micgresham/lr2-redux/9bdd61c0-d4aa-4cd3-b29d-1bbbb40d1ae0.jpg

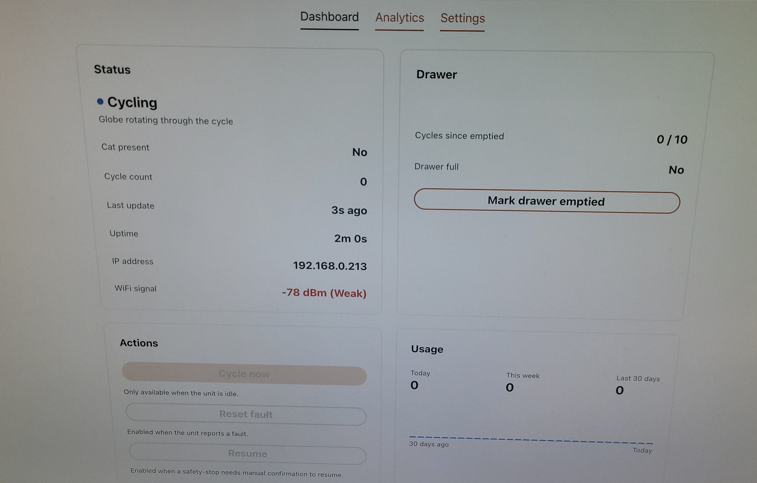
9bdd61c0-d4aa-4cd3-b29d-1bbbb40d1ae0.jpg
