micgresham/lr2-redux/20260726_155429.jpg

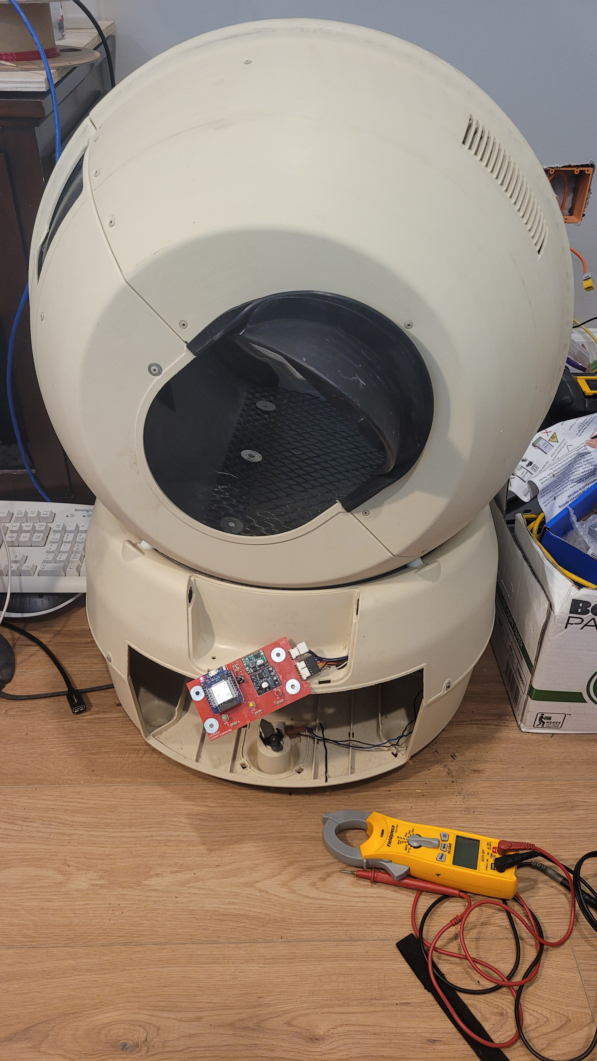
20260726_155429.jpg
