micgresham/lr2-redux/20260726_165318.jpg

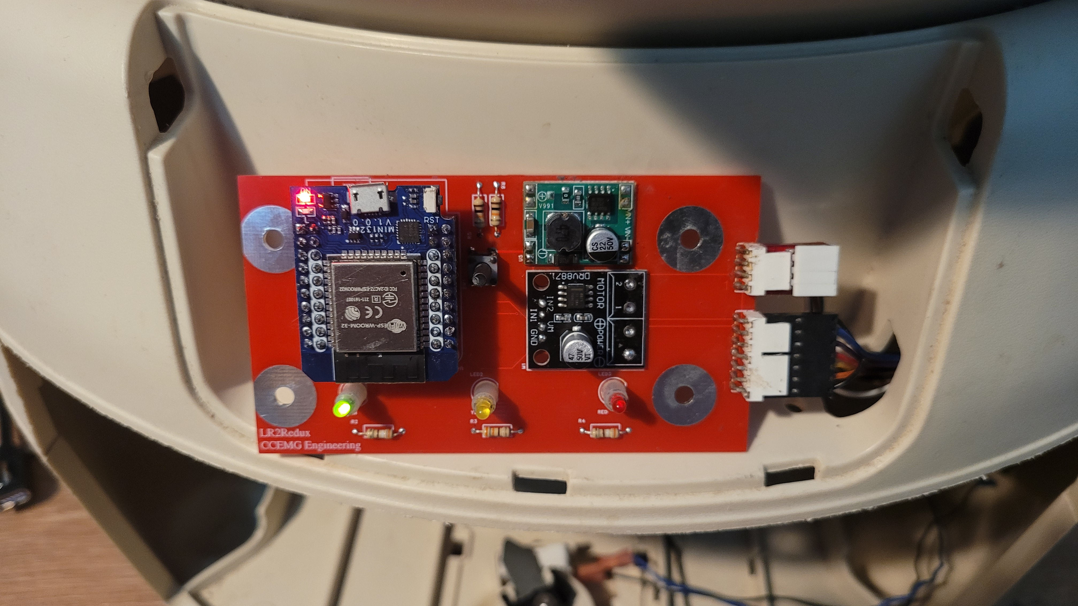
20260726_165318.jpg
