micgresham/lr2-redux/20260728_175901.jpg

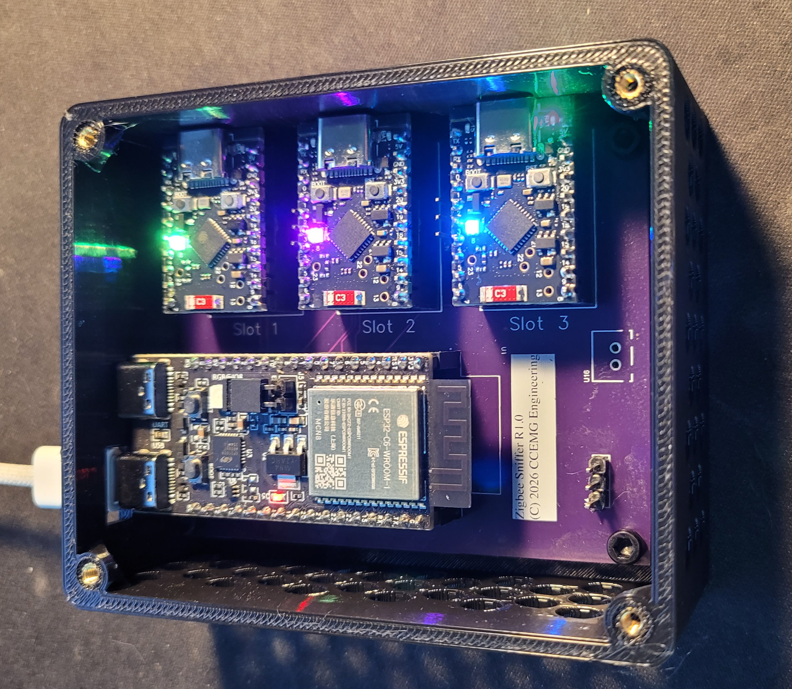
20260728_175901.jpg
