micgresham/lr2-redux/20260729_130526.jpg

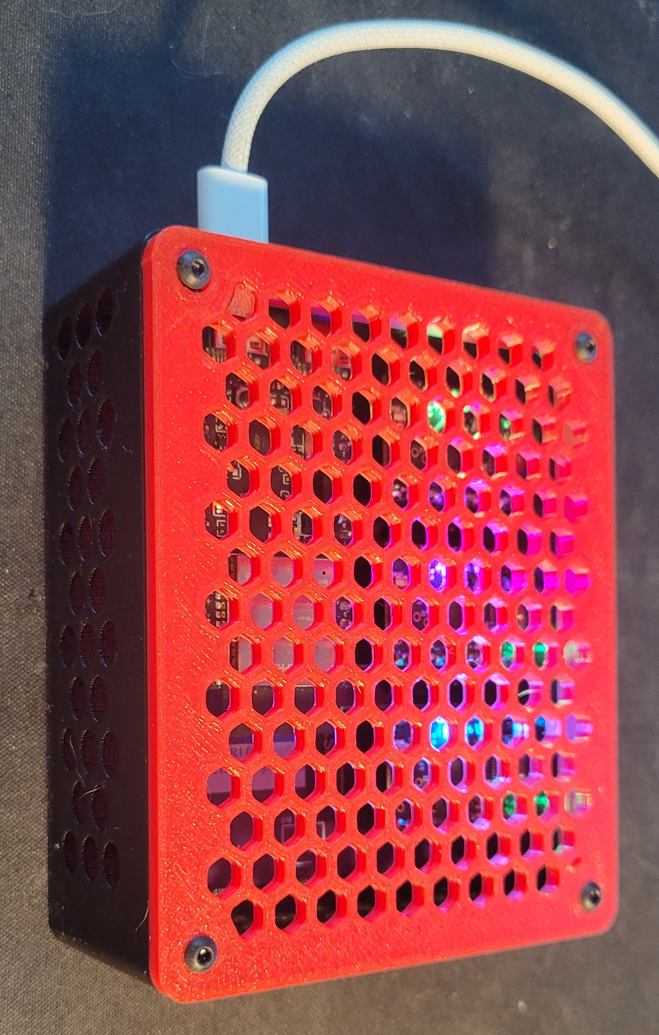
20260729_130526.jpg
