micgresham/lr2-redux/easyEDApro/BOM_Boardv2_PCBv2_2026-09-19.xlsx

No. | Quantity | Comment | Designator | Footprint | Value | Manufacturer Part | Manufacturer | Supplier Part | Supplier
1 | 1 | 470uF | C3 | CAP-TH_BD10.0-P5.00-D1.0-FD | 470uF | 25WXA470MEFC10X9 | Rubycon(红宝石) | C338182 | LCSC
2 | 6 | 100nF | C4,C6,C7,C8,C9,C10 | CAP-TH_L4.5-W3.5-P5.08-D0.5 | 100nF | CT4-0805-2X1-50V-0.1uF-K-Y | TORCH(火炬) | C41361550 | LCSC
3 | 1 | 100uF | C5 | CAP-TH_BD5.0-P2.00-D0.5-FD-1 | 100uF | 16V100uF CD288 | HRK(鸿瑞凯电子) | C2960195 | LCSC
4 | 1 | 2510-7A平弯 | CN2 | CONN-TH_7P-P2.54_KF2510-7AW |  | 2510-7A平弯 | BOOMELE(博穆精密) | C70896 | LCSC
5 | 1 | 2510-4A平弯 | CN3 | CONN-TH_4P-P2.54_KF2510-4AGW |  | 2510-4A平弯 | BOOMELE(博穆精密) | C31753 | LCSC
6 | 1 | PZ254V-11-03P | H3 | HDR-TH_3P-P2.54-V-M_PZ254V-11-03P |  | PZ254V-11-03P | XFCN(兴飞) | C2937625 | LCSC
7 | 1 | 333-2SYGD/S530-E2-L | LED1 | LED-TH_BD5.0-P2.54-FD |  | 333-2SYGD/S530-E2-L | EVERLIGHT(亿光) | C99697 | LCSC
8 | 2 | 333-2UYD/S530-A3-L | LED2,LED3 | LED-TH_BD5.0-P2.54-FD |  | 333-2UYD/S530-A3-L | EVERLIGHT(亿光) | C88602 | LCSC
9 | 1 | Adafruit DRV8871 | M1 | Adafruit DRV8871
10 | 3 | 220Ω | R2,R3,R4 | RES-TH_BD2.3-L6.5-P10.50-D0.5 | 220Ω | CF1/4W-220Ω±5% T | CCO(千志电子) | C120039 | LCSC
11 | 2 | 10kΩ | R5,R6 | RES-TH_BD2.7-L6.2-P10.20-D0.4 | 10kΩ | CR1/4W-10K±5%-OT52 | VO(翔胜) | C2894557 | LCSC
12 | 1 | LXW-TS-6X6X5-DIP | SW1 | SW-TH_4P-L6.0-W6.0-P4.50-LS6.5 |  | LXW-TS-6X6X5-DIP | LXWCONN(连兴旺电子) | C53447028 | LCSC
13 | 1 | Buck Converter | U5 | Buck Converter
14 | 1 | ESP32-C6 SuperMini | U6 | COMM-TH_ESP32-C6-SUPERMINI |  | ESP32-C6 SuperMini
