micgresham/lr2-redux/(list of files, drawings)

Other design files:
easyEDApro/LR2-controller.eprj
