micgresham/lr2-redux/(commit log)

2026-07-03 Initial commit: LR2-Redux control board firmware and dashboard
    ESP32 + L298N replacement control board for a Litter Robot 2 with a failed
    stock board. Includes:
    - Non-blocking state machine (BOOT_HOMING/IDLE/CAT_PRESENT/WAIT_TIMER/
    CYCLE_TO_DUMP/CYCLE_TO_HOME/SAFETY_STOP/FAULT) with MQTT + Home Assistant
    discovery, NVS-persisted cycle/drawer counters, OTA updates.
    - Runtime WiFi/MQTT/wait-timer config (NVS) with a SoftAP + captive portal
    setup flow, entered automatically when unconfigured or by holding the
    cycle button 10s.
    - A Grommet + React dashboard that talks to the board's own WebSocket
    server (no MQTT broker involved in the browser) and is served by the
    board itself from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
    [config.cpp, config.h, config_api.cpp, config_api.h, main.cpp, setup_portal.cpp, setup_portal.h]
2026-07-06 Add analytics, drawer-full setting, OTA, WiFi hardening, and doc corrections
    Firmware: runtime-configurable drawer-full threshold and day/night hours,
    per-visit-timestamp logging for the new Analytics dashboard tab, browser-based
    OTA upload, three-LED status scheme matching the original stock board,
    manual-reset/cooldown safety behavior, and a standalone diagnostic bring-up
    tool (env:diagnostic). Anti-pinch safety interlock now checked in every
    state, not just mid-motion, after real hardware testing showed it was being
    silently ignored while idle/waiting. Anti-pinch moved GPIO13->GPIO14 for an
    ESP32 mini board that doesn't break out GPIO13.
    WiFi reliability: dirty-reset WiFi/lwIP teardown,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
    [config.cpp, config.h, config_api.cpp, diagnostic_main.cpp, main.cpp]
2026-07-06 Rewrite project-story tone to cut corporate jargon
    Replaced stiff phrasing ("load-bearing", "this section will get a
    resolution once one actually lands", etc.) with plainer language per
    feedback that the write-up read like an executive deck rather than a
    grounded account of the actual work.
2026-07-06 Add parts-selection section to project story; note custom PCB effort
    New §05 "Picking the parts" covers why the ESP32 mini (has to fit the
    original enclosure/mounting footprint), L298N (already on hand), and buck
    converter (isolated 5V logic supply) were chosen. Also documents a custom
    PCB effort - sized to match the original controller's dimensions - that
    wasn't captured anywhere in the repo before now; schematic/layout is in
    progress. Renumbered later sections accordingly.
2026-07-07 Switch production motor driver from L298N to DRV8871
    DRV8871 has no separate enable/PWM pin, so motorStop/motorRunForward/
    motorRunReverse now PWM whichever of IN1/IN2 is the active direction
    directly instead of a static direction pin plus a separate ENA line.
    This preserves the existing MOTOR_SPEED softening on one less GPIO.
    The breadboard/diagnostic tool (diagnostic_main.cpp) is untouched and
    still targets an L298N with its ENA line, since driving that costs
    nothing there. Hardware-verified on the real DRV8871 board.
2026-07-12 Note custom PCB (PCB1) status in README
    Schematic/netlist for the ESP32-based replacement board was reviewed
    against the documented BOM/pinout; layout and fab are still open.
2026-07-31 Add configurable cycle timing, MQTT/HA expansion, and dashboard fixes
    Firmware: home overshoot and dump shake step/count are now runtime
    settings (previously hardcoded), exposed via the web Settings page and
    mirrored as writable MQTT/Home Assistant number/switch entities.
    Expanded MQTT with the previously WS-only telemetry (uptime, RSSI, IP,
    firmware build, needs-manual-reset, cat-present-warning) and added
    missing HA discovery for the reset_fault/resume buttons. Validation
    bounds for settings now live once in config.h, shared by the HTTP
    /save handler and the new MQTT path.
    Dashboard: uptime now formats as days-hours-mins-secs, added a CSV
    export for stored visits, duplicated the visit cha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
    [config.cpp, config.h, config_api.cpp, main.cpp]
2026-07-31 Fix dashboard save/reboot button getting stuck on "Saving..." forever
    The device's ESP.restart() right after /save doesn't always close the
    TCP connection cleanly, so fetch() could hang indefinitely instead of
    rejecting - leaving the button stuck with no error until a manual page
    refresh. Bound both the initial /save request and the reconnect-poll's
    /config requests with an AbortSignal timeout so they always settle.
2026-08-16 Harden mDNS/OTA re-arming, expose WiFi power-save state, tear down WiFi on SW reset
    mDNS re-arming previously fired only on a disconnect->connect transition,
    so anything that killed the responder without one went unnoticed until the
    next reconnect. It now restarts on three triggers, each logged with its
    reason: WiFi connect (unchanged), IP change (a DHCP renewal can hand out a
    new address without WiFi.status() ever leaving WL_CONNECTED, leaving a
    stale A record), and a 5-minute periodic refresh. Guarded so it never
    tears the responder down mid-flash, via an arduinoOtaInProgress flag set
    from the ArduinoOTA callbacks plus Update.isRunning() for the web OTA path.
    Investigation note: on this n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
    [main.cpp]
2026-08-29 Add ESP32-C6 SuperMini as a second build target
    Extracts the pin map out of main.cpp into include/pins.h, which selects
    between the classic ESP32 map (unchanged - this is the shipped/installed
    hardware) and a new ESP32-C6 SuperMini map by IDF target, so the right
    one falls out of `board` in platformio.ini with nothing to remember at
    build time. The C6 map is wired but not yet built or verified on real
    hardware.
    The C6 needs Arduino core 3.x, which dropped the channel-addressed LEDC
    API the motor PWM uses; motorPwmAttach/motorPwmWrite shim over that so
    the classic build can stay on core 2.0.17. The brownout-register poke is
    guarded to classic ESP32 only - RTC_CNTL_BROWN_OUT_REG has no C6
    equ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
    [partitions_c6.csv]
2026-08-29 Let a manual trigger cut the wait timer short
    WAIT_TIMER only watched the weight switch and its own elapsed time, so
    pressing the cycle button (or sending a `cycle` command over MQTT/WS)
    while the timer counted down was silently dropped until the machine got
    back to IDLE - you had to wait out the full timer anyway, which is the
    opposite of what "cycle now" means.
    The new branch is deliberately the identical transition to the
    timer-elapsed one rather than a separate path, so an early cycle runs the
    full normal sequence and counts toward cycleCount and the drawer-full
    tally like any timed cycle, with no "manual vs. timed" bookkeeping to
    keep in sync.
    Ordered after the weight-switch check, so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
    [main.cpp]
2026-09-05 Fix day/night visit averages counting the other window's hours
    "Average time between visits" filtered visits into a day list and a night
    list, then averaged the raw differences between consecutive entries. Those
    differences still span the excluded window: the gap from one evening's
    last daytime visit to the next morning's first contains the entire night,
    so a set of ordinary 2-4h daytime gaps averaged out to 7h50m on real data.
    Each gap is now clipped to the hours its own window actually covers. The
    clipper walks local-hour-aligned segments so the day/night classifier only
    ever sees an instant whose whole segment shares its local hour, and steps
    a fixed 3600s so it still terminates across a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
2026-09-12 Fix WiFi retry logic destroying its own connections; add setup-mode fallback
    The retry path had no CONNECTING phase: WiFi.begin() fired, the phase went
    straight back to IDLE, and WIFI_RECONNECT_INTERVAL_MS later it scanned and
    called begin() again on top of the in-flight attempt. WL_CONNECTED means
    "got a DHCP lease", not "associated", so a link that associated in 3s but
    needed 10s for DHCP was killed every single time. Serial capture showed both
    failure modes verbatim - "sta is connecting, cannot set config" (begin()
    silently doing nothing) and "STA currently connected. Disconnecting... Reason:
    8 - ASSOC_LEAVE" (deauthing ourselves). This is very likely the ASSOC_LEAVE
    loop chased since 202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
    [config.cpp, config.h, main.cpp, setup_portal.cpp]
2026-09-19 Add EasyEDA Pro PCB v2 design files and screenshots
    Project file, Gerbers, BOM, pick-and-place, plus schematic and 3D render
    screenshots for the custom LR2 Redux controller board.
    [BOM_Boardv2_PCBv2_2026-09-19.xlsx, LR2-controller.eprj, PickAndPlace_PCBv2_2026-09-19.xlsx]
